georgi901/chinese-dragon-automaton/Camshaft_endcap.stl

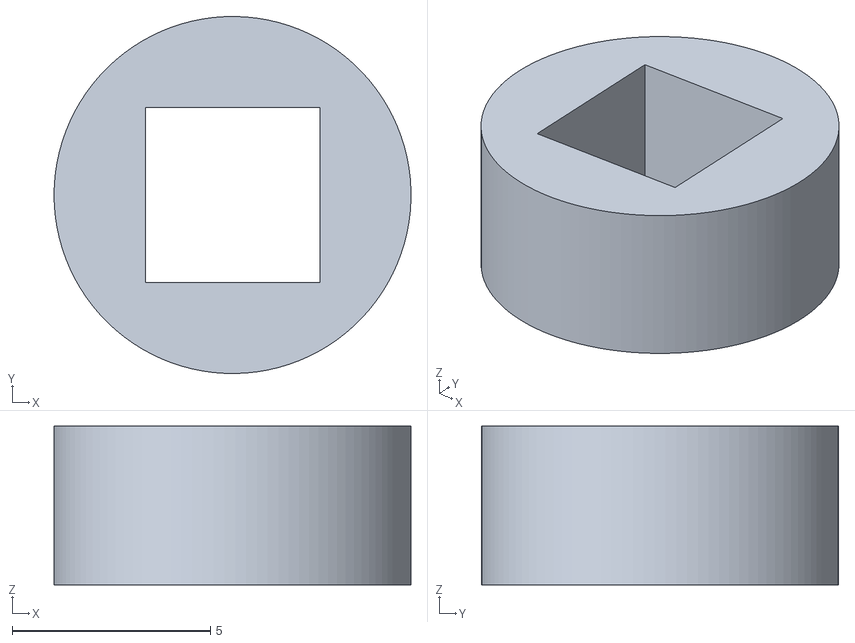
[picture p19: CAD file, 2026-10-13]
Camshaft_endcap.stl
9.00 x 9.00 x 4.00
