georgi901/chinese-dragon-automaton/Part2-Case.stl

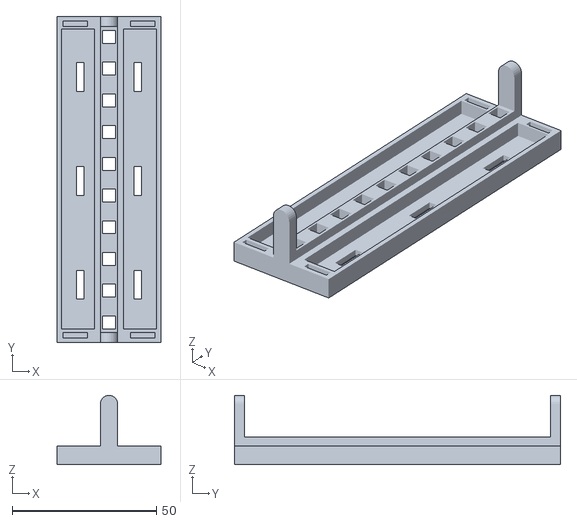
[picture p20: CAD file, 2026-10-13]
Part2-Case.stl
36.0 x 113.0 x 24.0
