georgi901/chinese-dragon-automaton/Camshaft.stl

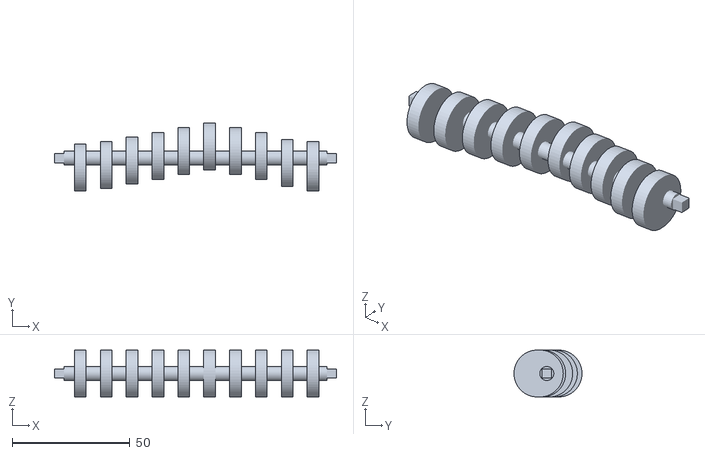
[picture p21: CAD file, 2026-10-13]
Camshaft.stl
120.0 x 29.0 x 20.0
