georgi901/chinese-dragon-automaton/Follower_rod.stl

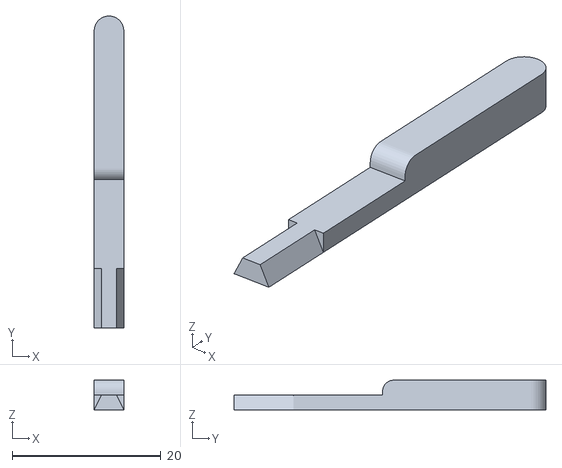
[picture p22: CAD file, 2026-10-13]
Follower_rod.stl
4.00 x 42.0 x 4.00
