georgi901/chinese-dragon-automaton/Crank_pivot.stl

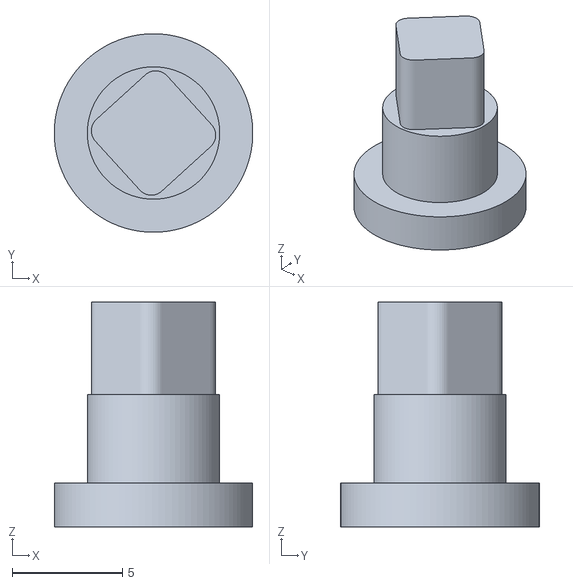
[picture p23: CAD file, 2026-10-13]
Crank_pivot.stl
9.00 x 9.00 x 10.2
