georgi901/chinese-dragon-automaton/Gear_small.stl

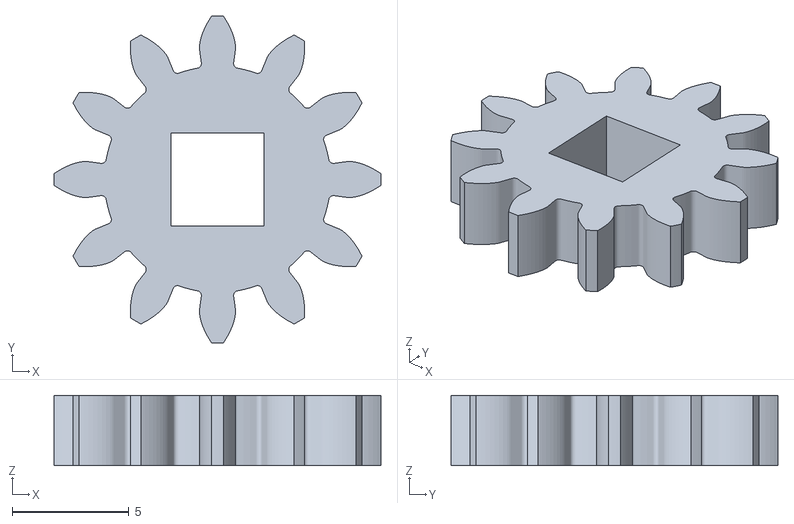
[picture p24: CAD file, 2026-10-13]
Gear_small.stl
14.0 x 14.0 x 3.00
