georgi901/chinese-dragon-automaton/Part1-Case.stl

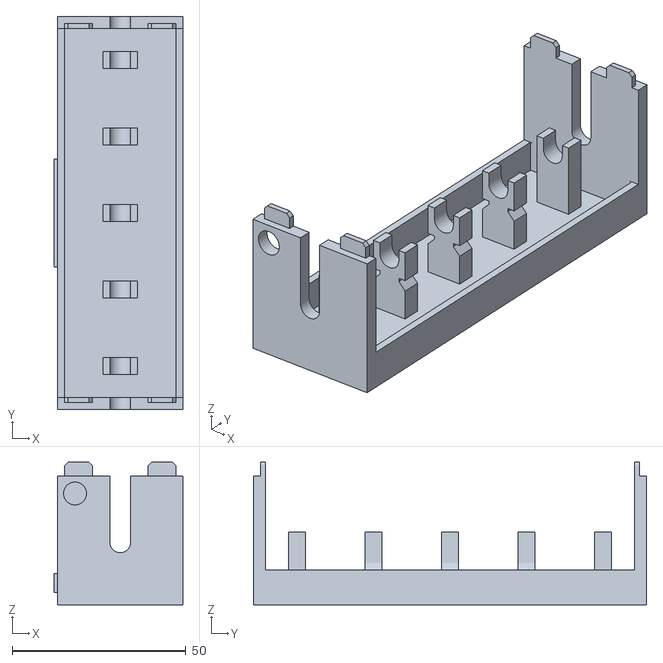
[picture p25: CAD file, 2026-10-13]
Part1-Case.stl
37.0 x 113.0 x 41.0
