georgi901/chinese-dragon-automaton/Crank_handle.stl

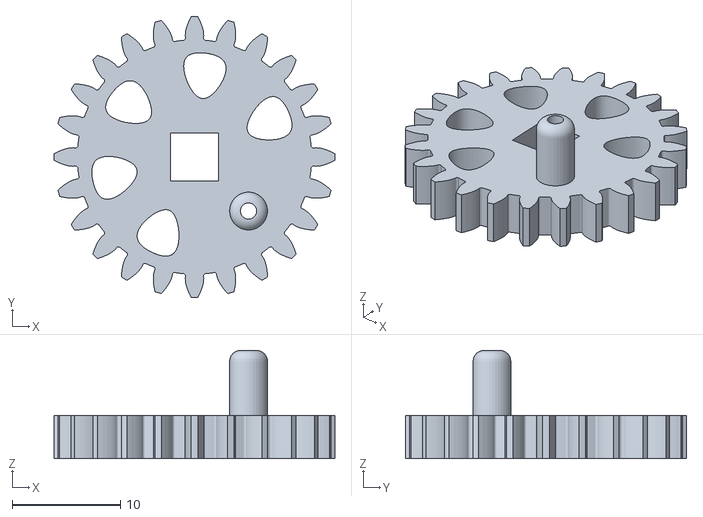
[picture p26: CAD file, 2026-10-13]
Crank_handle.stl
26.0 x 26.0 x 10.0
