georgi901/chinese-dragon-automaton/(commit log)

2026-06-05 Enhance README with detailed project information
    Expanded the README to include detailed descriptions of the mechanism, components, assembly notes, modeling process, and project status.
2026-10-13 Add STL models and update project README
    [Camshaft.stl, Camshaft_endcap.stl, Crank_handle.stl, Crank_pivot.stl, Follower_rod.stl, Gear_small.stl, Part1-Case.stl, Part2-Case.stl]
